fredzqm/CPU/RTL_control_states.xlsx

Sheet: Reg&Op code
OPCODE | 00 | 01 | 10 | 11
00 | add [R] | addi [I] | sto [R] | lui [I]
01 | sub [R] | cmp [R] | cp [R] | cpi [I]
10 | and [R] | xor [R] | push [R] | pop [R]
11 | or [R] | (blank) | jr [R] | jl/jal [J]
REGCODE | 0 | 1 | 10 | 11
0 | t0 | t1 | t2 | t3
1 | t4 | t5 | t6 | t7
10 | s0 | s1 | v0 | v1
11 | s2 | at | ra | dp

Sheet: RTL
 | Calculations | cmp | sto | cp | jr | jl | jal | addi | lui | cpi | push | pop
Cycle 1 | IR = Mem[PC] PC += 1
Cycle 2 | A = R[IR[11:8]] B = R[IR[7:4]] |  |  |  |  | PC += 1 B = Mem[PC] |  | A = R[IR[11:8]] B = R[IR[7:4]] | R[IR[11:8]] = Upper | R[IR[11:8]] = signE | $sp -= 1 | B = Mem[$bp]
LM cycle | A = R[IR[11:8]] B = Mem[B]
Cycle 3 | ALUO= A op B | flag = sign(A - B) | Mem[B] = A | R[IR[11:8]] = B | PC = B | PC = B | PC = B R[IR[11:8]] = PC | ALUO = A + SignE |  |  | Mem[$sp] = A | R[IR[11:8]] = B $sp +=1
Cycle 4 | R[IR[11:8]] = ALUO |  |  |  |  |  |  | R[IR[11:8]] = ALUO

Sheet: Control signals
 | Calculations | cmp | sto | cp | jr | jl | jal | addi | lui | cpi | push | pop
Cycle 1 | IW IorD = 1 PCW
Cycle 2 | LM = 0 |  |  |  |  | PCW LM = 1 IorD = 1 |  | LM = 0 | RW RWSrc = 101 | RW RWSrc = 111 | LM = 0 SPW SPIorD = 0 | LM = 1 IorD = 0 MSrc = 0
LM cycle | LM = 1 IorD = 0 MSrc = 1
Cycle 3 | SrcB = 0 ALUOp = op | SrcB = 0 ALUOp = (A - B) FU = 1 | MW IorD = 0 MSrc = 1 | RW RWSrc = 001 | PCW Jump |  | PCW Jump RW RWSrc = 011 | SrcB = 1 ALUOp = (A + B) |  |  | MW IorD = 0 MSrc = 0 | SPW SPIorD = 1
Cycle 4 | RW RWSrc = xx0 |  |  |  |  |  |  | RW RWSrc = xx0

Sheet: state
 | Calculations | cmp | sto | cp | jr | jl | jal | addi | lui | cpi | push | pop
Cycle 1 | State 1: Read instruction
Cycle 2 | State 2: Decode / load register value / write immediate
LM cycle | State 3: Load memory data
Cycle 3 | State 4: Calculations |  | State 5: memory write | State 6: cp | State 7: jump |  |  | State 4: Calculations |  |  | State 5: memory write | State 8: pop
Cycle 4 | State: 9 Register Write |  |  |  |  |  |  | State: 9 Register Write

Sheet: PCW
PCW = State1 | State2 & op = 1111 | State7
State | op | PCW* | Jump | Explanation
1 | x | 1 | 0 | Increment PC
2 | 1111 | 1 | 0 | skip jump address word
7 | x | 1 | 1 | jump

Sheet: Mem
MW = State5 IW = State1 LM = State2 & op(1) & op(0) | State3 IorD = State1 | State2 & op(2) MSrc = State3 | State5 & ~op(3)
State | op | MW* | IW* | LM | IorD | MSrc | explanation
1 | x | 0 | 1 | x | 1 | x | read instruction
2 | xx0x | 0 | 0 | 0 | x | x
 | 0010 | 0 | 0 | 0 | x | x | sto
 | 0110 | 0 | 0 | 0 | x | x | cp
 | 1010 | 0 | 0 | 0 | x | x | push
 | 1110 | 0 | 0 | 0 | x | x | jr
 | 0011 | 0 | 0 | x | x | x | lui
 | 0111 | 0 | 0 | x | x | x | cpi
 | 1011 | 0 | 0 | 1 | 0 | 0 | read poped data (pop)
 | 1111 | 0 | 0 | 1 | 1 | x | read jump address (jl/jal)
3 | x | 0 | 0 | 1 | 0 | 1 | load memory into B
5 | 0010 | 1 | 0 | x | 0 | 1 | sto
 | 1010 | 1 | 0 | x | 0 | 0 | push

Sheet: RegW
RW = State2 & op(0) & op(1) & ~op(3) | State6 | State7 & op(0) & LMC | State9 RWSrc(0) = ~State9 RWSrc(1) = State2 & op(2) | State7 RWSrc(2) = State2
State | op | LMC | RW* | RWSrc | Explanation
2 | 0011 | x | 1 | 101 | lui
 | 0111 | x | 1 | 111 | cpi
6 | x | x | 1 | 001 | cp
7 | 1111 | 1 | 1 | 011 | jal
9 | x | x | 1 | xx0 | write calculated data

Sheet: ALU
SrcB = State9 & op = 0001 ALUOp = op(3)op(2)op(0)
State | op | SrcB | ALUOp
9 | 0001 | 1 | op(3)op(2)op(0)
 | - | 0
State | op |  | FU
9 | 0101 |  | 1
SPW = State2 & op = 1010 | State*
State | op | SPW* | SPIorD
2 | 1010 | 1 | 0
8 | x | 1 | 1

Sheet: nextState
State | Perform | op |  |  |  | instruct | LM = 0 | LM = 1
 |  | op(1) | op(0) | op(3) | op(2) |  | 0 | 1
State 1: Read instruction | x | x | x | x | x |  | 2 | 2
State 2: Decode / load register value / write immediate | 0 | x | x | x | x |  | 1 | 1
 | 1 | 0 | 0 | x | x |  | 4 | 3
 | 1 | 0 | 1 | 0 | 0 | addi | 4 | 4
 | 1 | 0 | 1 | 0 | 1 | cmp | 4 | 3
 | 1 | 0 | 1 | 1 | 0 | xor | 4 | 3
 | 1 | 1 | 0 | 0 | 0 | sto | 5 | 3
 | 1 | 1 | 0 | 0 | 1 | cp | 6 | 3
 | 1 | 1 | 0 | 1 | 0 | push | 5 | 6
 | 1 | 1 | 0 | 1 | 1 | jr | 7 | 3
 | 1 | 1 | 1 | 0 | 0 | lui | 1 | 1
 | 1 | 1 | 1 | 0 | 1 | cpi | 1 | 1
 | 1 | 1 | 1 | 1 | 0 | pop | 8 | 8
 | 1 | 1 | 1 | 1 | 1 | jl/jal | 7 | 7
State 3: Load memory data | 1 | 0 | x | x | x |  | 4
 | 1 | 1 | 0 | 0 | 0 | sto | 5
 | 1 | 1 | 0 | 0 | 1 | cp | 6
 | 1 | 1 | 0 | 1 | 1 | jr | 7
State 4: Calculations | 1 | 0 | 1 | 0 | 1 | cmp | 1
 | - | - | - | - | - |  | 9
State 5: memory write | 1 | 1 | 0 | 0 | 0 | sto | 1
 | 1 | 1 | 0 | 1 | 0 | push | 1
State 6: cp | 1 | 1 | 0 | 0 | 1 | cp | 1
State 7: jump | 1 | 1 | 0 | 1 | 1 | jr | 1
 | 1 | 1 | 1 | 1 | 1 | jl | 1
 | 1 | 1 | 1 | 1 | 1 | jal | 1
State 8: pop | 1 | 1 | 1 | 1 | 0 | pop | 1
State: 9 Register Write | 1 | 0 | 0 | x | x |  | 1
 | 1 | 0 | 1 | 0 | 0 | addi | 1
 | 1 | 0 | 1 | 1 | 0 | xor | 1

Sheet: nextStateC
State | Perform | op |  |  |  | instruction | LM = 0 | LM = 1
 |  | op(1) | op(0) | op(3) | op(2) |  | 0 | 1
State 1: Read instruction | x | x | x | x | x |  | 2 | 2
State 2: Decode / load register value / write immediate | 0 | x | x | x | x |  | 1 | 1
 | 1 | 0 | 0 | 0 | 0 | add | 4 | 3
 | 1 | 0 | 0 | 0 | 1 | sub | 4 | 3
 | 1 | 0 | 0 | 1 | 0 | and | 4 | 3
 | 1 | 0 | 0 | 1 | 1 | or | 4 | 3
 | 1 | 0 | 1 | 0 | 0 | addi | 4 | 4 | OPCODE | 00 | 01 | 10 | 11
 | 1 | 0 | 1 | 0 | 1 | cmp | 4 | 3 | 00 | add [R] | addi [I] | sto [R] | lui [I]
 | 1 | 0 | 1 | 1 | 0 | xor | 4 | 3 | 01 | sub [R] | cmp [R] | cp [R] | cpi [I]
 | 1 | 0 | 1 | 1 | 1 | ??? | x | x | 10 | and [R] | xor [R] | push [R] | pop [R]
 | 1 | 1 | 0 | 0 | 0 | sto | 5 | 3 | 11 | or [R] | (blank) | jr [R] | jl/jal [J]
 | 1 | 1 | 0 | 0 | 1 | cp | 6 | 3
 | 1 | 1 | 0 | 1 | 0 | push | 5 | 6
 | 1 | 1 | 0 | 1 | 1 | jr | 7 | 3
 | 1 | 1 | 1 | 0 | 0 | lui | 1 | 1
 | 1 | 1 | 1 | 0 | 1 | cpi | 1 | 1
 | 1 | 1 | 1 | 1 | 0 | pop | 8 | 8
 | 1 | 1 | 1 | 1 | 1 | jl | 7 | 7
 | 1 | 1 | 1 | 1 | 1 | jal | 7 | 7
State 3: Load memory data | 0 | x | x | x | x |  | x | x
 | 1 | 0 | 0 | 0 | 0 | add | x | 4
 | 1 | 0 | 0 | 0 | 1 | sub | x | 4
 | 1 | 0 | 0 | 1 | 0 | and | x | 4
 | 1 | 0 | 0 | 1 | 1 | or | x | 4
 | 1 | 0 | 1 | 0 | 0 | addi | x | x
 | 1 | 0 | 1 | 0 | 1 | cmp | x | 4
 | 1 | 0 | 1 | 1 | 0 | xor | x | 4
 | 1 | 0 | 1 | 1 | 1 | ??? | x | x
 | 1 | 1 | 0 | 0 | 0 | sto | x | 5
 | 1 | 1 | 0 | 0 | 1 | cp | x | 6
 | 1 | 1 | 0 | 1 | 0 | push | x | x
 | 1 | 1 | 0 | 1 | 1 | jr | x | 7
 | 1 | 1 | 1 | 0 | 0 | lui | x | x
 | 1 | 1 | 1 | 0 | 1 | cpi | x | x
 | 1 | 1 | 1 | 1 | 0 | pop | x | x
 | 1 | 1 | 1 | 1 | 1 | jl | x | x
 | 1 | 1 | 1 | 1 | 1 | jal | x | x
State 4: Calculations | 0 | x | x | x | x |  | x | x
 | 1 | 0 | 0 | 0 | 0 | add | 9 | 9
 | 1 | 0 | 0 | 0 | 1 | sub | 9 | 9
 | 1 | 0 | 0 | 1 | 0 | and | 9 | 9
 | 1 | 0 | 0 | 1 | 1 | or | 9 | 9
 | 1 | 0 | 1 | 0 | 0 | addi | 9 | 9
 | 1 | 0 | 1 | 0 | 1 | cmp | 1 | 1
 | 1 | 0 | 1 | 1 | 0 | xor | 9 | 9
 | 1 | 0 | 1 | 1 | 1 | ??? | x | x
 | 1 | 1 | 0 | 0 | 0 | sto | x | x
 | 1 | 1 | 0 | 0 | 1 | cp | x | x
 | 1 | 1 | 0 | 1 | 0 | push | x | x
 | 1 | 1 | 0 | 1 | 1 | jr | x | x
 | 1 | 1 | 1 | 0 | 0 | lui | x | x
 | 1 | 1 | 1 | 0 | 1 | cpi | x | x
 | 1 | 1 | 1 | 1 | 0 | pop | x | x
 | 1 | 1 | 1 | 1 | 1 | jl | x | x
 | 1 | 1 | 1 | 1 | 1 | jal | x | x
State 5: memory write | 0 | x | x | x | x |  | x | x
 | 1 | 0 | 0 | 0 | 0 | add | x | x
 | 1 | 0 | 0 | 0 | 1 | sub | x | x
 | 1 | 0 | 0 | 1 | 0 | and | x | x
 | 1 | 0 | 0 | 1 | 1 | or | x | x
 | 1 | 0 | 1 | 0 | 0 | addi | x | x
 | 1 | 0 | 1 | 0 | 1 | cmp | x | x
 | 1 | 0 | 1 | 1 | 0 | xor | x | x
 | 1 | 0 | 1 | 1 | 1 | ??? | x | x
 | 1 | 1 | 0 | 0 | 0 | sto | 1 | 1
 | 1 | 1 | 0 | 0 | 1 | cp | x | x
 | 1 | 1 | 0 | 1 | 0 | push | 1 | 1
 | 1 | 1 | 0 | 1 | 1 | jr | x | x
 | 1 | 1 | 1 | 0 | 0 | lui | x | x
 | 1 | 1 | 1 | 0 | 1 | cpi | x | x
 | 1 | 1 | 1 | 1 | 0 | pop | x | x
 | 1 | 1 | 1 | 1 | 1 | jl | x | x
 | 1 | 1 | 1 | 1 | 1 | jal | x | x
State 6: cp | 0 | x | x | x | x |  | x | x
 | 1 | 0 | 0 | 0 | 0 | add | x | x
 | 1 | 0 | 0 | 0 | 1 | sub | x | x
 | 1 | 0 | 0 | 1 | 0 | and | x | x
 | 1 | 0 | 0 | 1 | 1 | or | x | x
 | 1 | 0 | 1 | 0 | 0 | addi | x | x
 | 1 | 0 | 1 | 0 | 1 | cmp | x | x
 | 1 | 0 | 1 | 1 | 0 | xor | x | x
 | 1 | 0 | 1 | 1 | 1 | ??? | x | x
 | 1 | 1 | 0 | 0 | 0 | sto | x | x
 | 1 | 1 | 0 | 0 | 1 | cp | 1 | 1
 | 1 | 1 | 0 | 1 | 0 | push | x | x
 | 1 | 1 | 0 | 1 | 1 | jr | x | x
 | 1 | 1 | 1 | 0 | 0 | lui | x | x
 | 1 | 1 | 1 | 0 | 1 | cpi | x | x
 | 1 | 1 | 1 | 1 | 0 | pop | x | x
 | 1 | 1 | 1 | 1 | 1 | jl | x | x
 | 1 | 1 | 1 | 1 | 1 | jal | x | x
State 7: jump | 0 | x | x | x | x |  | x | x
 | 1 | 0 | 0 | 0 | 0 | add | x | x
 | 1 | 0 | 0 | 0 | 1 | sub | x | x
 | 1 | 0 | 0 | 1 | 0 | and | x | x
 | 1 | 0 | 0 | 1 | 1 | or | x | x
 | 1 | 0 | 1 | 0 | 0 | addi | x | x
 | 1 | 0 | 1 | 0 | 1 | cmp | x | x
 | 1 | 0 | 1 | 1 | 0 | xor | x | x
 | 1 | 0 | 1 | 1 | 1 | ??? | x | x
 | 1 | 1 | 0 | 0 | 0 | sto | x | x
 | 1 | 1 | 0 | 0 | 1 | cp | x | x
 | 1 | 1 | 0 | 1 | 0 | push | x | x
 | 1 | 1 | 0 | 1 | 1 | jr | 1 | x
 | 1 | 1 | 1 | 0 | 0 | lui | x | x
 | 1 | 1 | 1 | 0 | 1 | cpi | x | x
 | 1 | 1 | 1 | 1 | 0 | pop | x | x
 | 1 | 1 | 1 | 1 | 1 | jl | 1 | x
 | 1 | 1 | 1 | 1 | 1 | jal | 1 | x
State 8: pop | 0 | x | x | x | x |  | x | x
 | 1 | 0 | 0 | 0 | 0 | add | x | x
 | 1 | 0 | 0 | 0 | 1 | sub | x | x
 | 1 | 0 | 0 | 1 | 0 | and | x | x
 | 1 | 0 | 0 | 1 | 1 | or | x | x
 | 1 | 0 | 1 | 0 | 0 | addi | x | x
 | 1 | 0 | 1 | 0 | 1 | cmp | x | x
 | 1 | 0 | 1 | 1 | 0 | xor | x | x
 | 1 | 0 | 1 | 1 | 1 | ??? | x | x
 | 1 | 1 | 0 | 0 | 0 | sto | x | x
 | 1 | 1 | 0 | 0 | 1 | cp | x | x
 | 1 | 1 | 0 | 1 | 0 | push | x | x
 | 1 | 1 | 0 | 1 | 1 | jr | x | x
 | 1 | 1 | 1 | 0 | 0 | lui | x | x
 | 1 | 1 | 1 | 0 | 1 | cpi | x | x
 | 1 | 1 | 1 | 1 | 0 | pop | 1 | 1
 | 1 | 1 | 1 | 1 | 1 | jl | x | x
 | 1 | 1 | 1 | 1 | 1 | jal | x | x
State: 9 Register Write | 0 | x | x | x | x |  | x | x
 | 1 | 0 | 0 | 0 | 0 | add | 1 | 1
 | 1 | 0 | 0 | 0 | 1 | sub | 1 | 1
 | 1 | 0 | 0 | 1 | 0 | and | 1 | 1
 | 1 | 0 | 0 | 1 | 1 | or | 1 | 1
 | 1 | 0 | 1 | 0 | 0 | addi | 1 | 1
 | 1 | 0 | 1 | 0 | 1 | cmp | x | x
 | 1 | 0 | 1 | 1 | 0 | xor | 1 | 1
 | 1 | 0 | 1 | 1 | 1 | ??? | x | x
 | 1 | 1 | 0 | 0 | 0 | sto | x | x
 | 1 | 1 | 0 | 0 | 1 | cp | x | x
 | 1 | 1 | 0 | 1 | 0 | push | x | x
 | 1 | 1 | 0 | 1 | 1 | jr | x | x
 | 1 | 1 | 1 | 0 | 0 | lui | x | x
 | 1 | 1 | 1 | 0 | 1 | cpi | x | x
 | 1 | 1 | 1 | 1 | 0 | pop | x | x
 | 1 | 1 | 1 | 1 | 1 | jl | x | x
 | 1 | 1 | 1 | 1 | 1 | jal | x | x
