fredzqm/CPU/Xilinx_implementation/SystemTest/calc instructions.docx

writeMem(10, 16'b0110000100101111);

writeReg( 2, 16'h0112);

writeMem(16'h0112, 12);

run(10,1);

readReg(1, out);

if(out == 12)

$display("----------------good cp1" );

else

$display("-----------------bad cp1" );

writeMem(11, 16'b0110000100100111);

writeReg( 2, 16'h0033);

run(11,1);

readReg(1, out);

if(out == 16'h0033)

$display("----------------good cp2" );

else

$display("-----------------bad cp2" );

writeMem(12, 16'b0110000100100100);

writeReg( 2, 16'h0022);

run(12,1);

readReg(1, out);

if(out == 16'h0033)

$display("----------------good cp3" );

else

$display("-----------------bad cp3" );

writeMem(13, 16'b0000000100100111);

writeReg( 1, 16'h0002);

writeReg( 2, 16'h0003);

run(13,1);

readReg(1, out);

if(out == 16'h0005)

$display("----------------good add1" );

else

$display("-----------------bad add1" );

writeMem(14, 16'b0000000100101111);

writeReg( 1, 16'h0003);

writeReg( 2, 16'h0002);

writeMem( 2, 4);

run(14,1);

readReg(1, out);

if(out == 16'h0007)

$display("----------------good add2" );

else

$display("-----------------bad add2" );

writeMem(15, 16'b0000000100100110);

writeReg( 1, 16'h0002);

writeReg( 2, 16'h0003);

run(15,1);

readReg(1, out);

if(out == 16'h0002)

$display("----------------good add3" );

else

$display("-----------------bad add3" );

writeMem(16, 16'b0000000100100111);

writeReg( 1, 16'h7fff);

writeReg( 2, 16'h0001);

run(16,1);

readReg(1, out);

if(out == 16'h8000)

$display("----------------good add4" );

else

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

else

$display("-----------------bad or2" );

writeMem(32, 16'b1100000100100100);

writeReg( 1, 16'h0002);

writeReg( 2, 16'h0003);

run(32,1);

readReg(1, out);

if(out == 16'h0002)

$display("----------------good or3" );

else

$display("-----------------bad or3" );
