fredzqm/CPU/StateDiagram.pdf

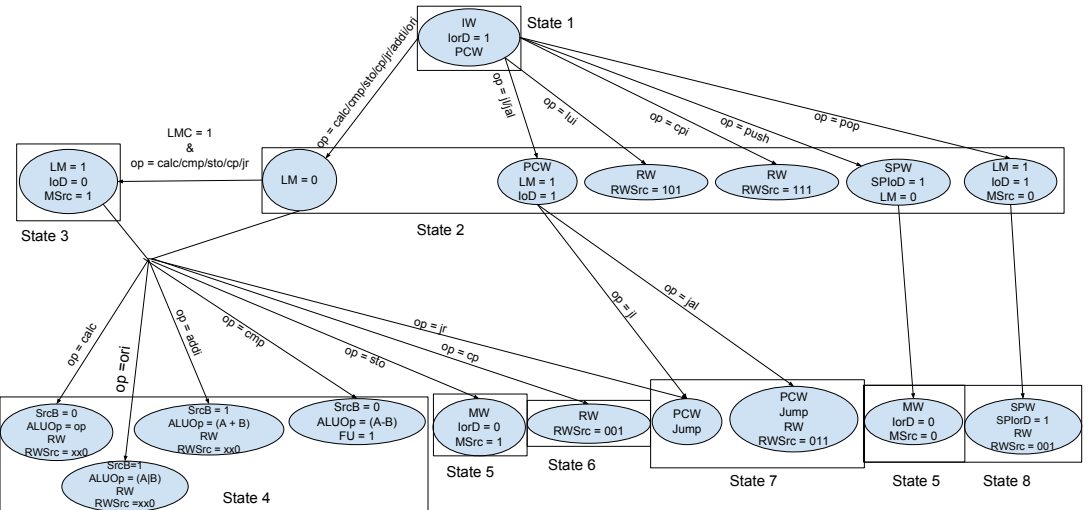
[picture p8: page 1]
IW IorD = 1 PCW; PCW LM = 1 IoD = 1; RW RWSrc = 101; RW RWSrc = 111; SPW SPIoD = 1 LM = 0; LM = 1 IoD = 1 MSrc = 0; LM = 1 IoD = 0 MSrc = 1; SrcB = 0 ALUOp = op RW RWSrc = xx0; SrcB = 0 ALUOp = (A-B) FU = 1; MW IorD = 0 MSrc = 1; RW RWSrc = 001; PCW Jump; SrcB = 1 ALUOp = (A + B) RW RWSrc = xx0; PCW Jump RW RWSrc = 011; MW IorD = 0 MSrc = 0; SPW SPIorD = 1 RW RWSrc = 001; LMC = 1 &; op = cpi; op = push; op = pop; op = lui; op = jal; op = sto; op = addi; op = calc; op = cmp; State 1; State 7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

op = calc/cmp/sto/cp/jr/addi/ori

op = jl/jal

op = calc/cmp/sto/cp/jr
