fredzqm/CPU/Xilinx_implementation/IO/debounce/ipcore_dir/debounce_counter.v

////////////////////////////////////////////////////////////////////////////////
// Copyright (c) 1995-2013 Xilinx, Inc.  All rights reserved.
////////////////////////////////////////////////////////////////////////////////
//   ____  ____
//  /   /\/   /
// /___/  \  /    Vendor: Xilinx
// \   \   \/     Version: P.20131013
//  \   \         Application: netgen
//  /   /         Filename: debounce_counter.v
// /___/   /\     Timestamp: Mon Nov  9 21:00:09 2015
// \   \  /  \ 
//  \___\/\___\
//             
// Command	: -w -sim -ofmt verilog /home/fredzqm/cpu-csse232/1516a-csse232-fineral-kerrickm-yangr-zhangq2/Xilinx/IO/debounce/ipcore_dir/tmp/_cg/debounce_counter.ngc /home/fredzqm/cpu-csse232/1516a-csse232-fineral-kerrickm-yangr-zhangq2/Xilinx/IO/debounce/ipcore_dir/tmp/_cg/debounce_counter.v 
// Device	: 3s500efg320-4
// Input file	: /home/fredzqm/cpu-csse232/1516a-csse232-fineral-kerrickm-yangr-zhangq2/Xilinx/IO/debounce/ipcore_dir/tmp/_cg/debounce_counter.ngc
// Output file	: /home/fredzqm/cpu-csse232/1516a-csse232-fineral-kerrickm-yangr-zhangq2/Xilinx/IO/debounce/ipcore_dir/tmp/_cg/debounce_counter.v
// # of Modules	: 1
// Design Name	: debounce_counter
// Xilinx        : /opt/Xilinx/14.7/ISE_DS/ISE/
//             
// Purpose:    
//     This verilog netlist is a verification model and uses simulation 
//     primitives which may not represent the true implementation of the 
//     device, however the netlist is functionally correct and should not 
//     be modified. This file cannot be synthesized and should only be used 
//     with supported simulation tools.
//             
// Reference:  
//     Command Line Tools User Guide, Chapter 23 and Synthesis and Simulation Design Guide, Chapter 6
//             
////////////////////////////////////////////////////////////////////////////////

`timescale 1 ns/1 ps

module debounce_counter (
  clk, ce, thresh0, sclr, q
)/* synthesis syn_black_box syn_noprune=1 */;
  input clk;
  input ce;
  output thresh0;
  input sclr;
  output [15 : 0] q;
  
  // synthesis translate_off
  
  wire \blk00000001/sig0000004b ;
  wire \blk00000001/sig0000004a ;
  wire \blk00000001/sig00000049 ;
  wire \blk00000001/sig00000048 ;
  wire \blk00000001/sig00000047 ;
  wire \blk00000001/sig00000046 ;
  wire \blk00000001/sig00000045 ;
  wire \blk00000001/sig00000044 ;
  wire \blk00000001/sig00000043 ;
  wire \blk00000001/sig00000042 ;
  wire \blk00000001/sig00000041 ;
  wire \blk00000001/sig00000040 ;
  wire \blk00000001/sig0000003f ;
  wire \blk00000001/sig0000003e ;
  wire \blk00000001/sig0000003d ;
  wire \blk00000001/sig0000003c ;
  wire \blk00000001/sig0000003b ;
  wire \blk00000001/sig0000003a ;
  wire \blk00000001/sig00000039 ;
  wire \blk00000001/sig00000038 ;
  wire \blk00000001/sig00000027 ;
  wire \blk00000001/sig00000026 ;
  wire \blk00000001/sig00000025 ;
  wire \blk00000001/sig00000024 ;
  wire \blk00000001/sig00000023 ;
  wire \blk00000001/sig00000022 ;
  wire \blk00000001/sig00000021 ;
  wire \blk00000001/sig00000020 ;
  wire \blk00000001/sig0000001f ;
  wire \blk00000001/sig0000001e ;
  wire \blk00000001/sig0000001d ;
  wire \blk00000001/sig0000001c ;
  wire \blk00000001/sig0000001b ;
  wire \blk00000001/sig0000001a ;
  wire \blk00000001/sig00000019 ;
  wire \blk00000001/sig00000018 ;
  wire \blk00000001/sig00000016 ;
  wire \blk00000001/sig00000015 ;
  wire \blk00000001/sig00000014 ;
  wire \blk00000001/sig00000013 ;
  wire \blk00000001/sig00000012 ;
  wire \blk00000001/sig00000011 ;
  wire \blk00000001/sig00000010 ;
  wire \blk00000001/sig0000000f ;
  wire \blk00000001/sig0000000e ;
  wire \blk00000001/sig0000000d ;
  wire \blk00000001/sig0000000c ;
  wire \blk00000001/sig0000000b ;
  wire \blk00000001/sig0000000a ;
  wire \blk00000001/sig00000009 ;
  wire \blk00000001/sig00000008 ;
  wire \blk00000001/sig00000007 ;
  wire \blk00000001/sig00000005 ;
  wire \blk00000001/sig00000004 ;
  wire \blk00000001/sig00000003 ;
  wire [15 : 0] NlwRenamedSig_OI_q;
  assign
    q[15] = NlwRenamedSig_OI_q[15],
    q[14] = NlwRenamedSig_OI_q[14],
    q[13] = NlwRenamedSig_OI_q[13],
    q[12] = NlwRenamedSig_OI_q[12],
    q[11] = NlwRenamedSig_OI_q[11],
    q[10] = NlwRenamedSig_OI_q[10],
    q[9] = NlwRenamedSig_OI_q[9],
    q[8] = NlwRenamedSig_OI_q[8],
    q[7] = NlwRenamedSig_OI_q[7],
    q[6] = NlwRenamedSig_OI_q[6],
    q[5] = NlwRenamedSig_OI_q[5],
    q[4] = NlwRenamedSig_OI_q[4],
    q[3] = NlwRenamedSig_OI_q[3],
    q[2] = NlwRenamedSig_OI_q[2],
    q[1] = NlwRenamedSig_OI_q[1],
    q[0] = NlwRenamedSig_OI_q[0];
  LUT4_L #(
    .INIT ( 16'h8000 ))
  \blk00000001/blk00000049  (
    .I0(\blk00000001/sig0000000a ),
    .I1(\blk00000001/sig00000009 ),
    .I2(\blk00000001/sig00000012 ),
    .I3(\blk00000001/sig00000004 ),
    .LO(\blk00000001/sig00000049 )
  );
  LUT2_L #(
    .INIT ( 4'h8 ))
  \blk00000001/blk00000048  (
    .I0(\blk00000001/sig00000007 ),
    .I1(\blk00000001/sig0000000e ),
    .LO(\blk00000001/sig0000004b )
  );
  INV   \blk00000001/blk00000047  (
    .I(NlwRenamedSig_OI_q[0]),
    .O(\blk00000001/sig00000027 )
  );
  LUT3 #(
    .INIT ( 8'h80 ))
  \blk00000001/blk00000046  (
    .I0(\blk00000001/sig0000000f ),
    .I1(\blk00000001/sig00000010 ),
    .I2(\blk00000001/sig00000011 ),
    .O(\blk00000001/sig00000004 )
  );
  LUT1 #(
    .INIT ( 2'h2 ))
  \blk00000001/blk00000045  (
    .I0(NlwRenamedSig_OI_q[14]),
    .O(\blk00000001/sig0000003c )
  );
  LUT1 #(
    .INIT ( 2'h2 ))
  \blk00000001/blk00000044  (
    .I0(NlwRenamedSig_OI_q[13]),
    .O(\blk00000001/sig0000003b )
  );
  LUT1 #(
    .INIT ( 2'h2 ))
  \blk00000001/blk00000043  (
    .I0(NlwRenamedSig_OI_q[12]),
    .O(\blk00000001/sig0000003a )
  );
  LUT1 #(
    .INIT ( 2'h2 ))
  \blk00000001/blk00000042  (
    .I0(NlwRenamedSig_OI_q[11]),
    .O(\blk00000001/sig00000039 )
  );
  LUT1 #(
    .INIT ( 2'h2 ))
  \blk00000001/blk00000041  (
    .I0(NlwRenamedSig_OI_q[10]),
    .O(\blk00000001/sig00000038 )
  );
  LUT1 #(
    .INIT ( 2'h2 ))
  \blk00000001/blk00000040  (
    .I0(NlwRenamedSig_OI_q[9]),
    .O(\blk00000001/sig00000045 )
  );
  LUT1 #(
    .INIT ( 2'h2 ))
  \blk00000001/blk0000003f  (
    .I0(NlwRenamedSig_OI_q[8]),
    .O(\blk00000001/sig00000044 )
  );
  LUT1 #(
    .INIT ( 2'h2 ))
  \blk00000001/blk0000003e  (
    .I0(NlwRenamedSig_OI_q[7]),
    .O(\blk00000001/sig00000043 )
  );
  LUT1 #(
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
  );
  XORCY   \blk00000001/blk00000012  (
    .CI(\blk00000001/sig00000022 ),
    .LI(\blk00000001/sig00000042 ),
    .O(\blk00000001/sig00000013 )
  );
  MUXCY   \blk00000001/blk00000011  (
    .CI(\blk00000001/sig00000022 ),
    .DI(\blk00000001/sig00000003 ),
    .S(\blk00000001/sig00000042 ),
    .O(\blk00000001/sig00000023 )
  );
  XORCY   \blk00000001/blk00000010  (
    .CI(\blk00000001/sig00000021 ),
    .LI(\blk00000001/sig00000041 ),
    .O(\blk00000001/sig00000012 )
  );
  MUXCY   \blk00000001/blk0000000f  (
    .CI(\blk00000001/sig00000021 ),
    .DI(\blk00000001/sig00000003 ),
    .S(\blk00000001/sig00000041 ),
    .O(\blk00000001/sig00000022 )
  );
  XORCY   \blk00000001/blk0000000e  (
    .CI(\blk00000001/sig00000020 ),
    .LI(\blk00000001/sig00000040 ),
    .O(\blk00000001/sig00000011 )
  );
  MUXCY   \blk00000001/blk0000000d  (
    .CI(\blk00000001/sig00000020 ),
    .DI(\blk00000001/sig00000003 ),
    .S(\blk00000001/sig00000040 ),
    .O(\blk00000001/sig00000021 )
  );
  XORCY   \blk00000001/blk0000000c  (
    .CI(\blk00000001/sig0000001f ),
    .LI(\blk00000001/sig0000003f ),
    .O(\blk00000001/sig00000010 )
  );
  MUXCY   \blk00000001/blk0000000b  (
    .CI(\blk00000001/sig0000001f ),
    .DI(\blk00000001/sig00000003 ),
    .S(\blk00000001/sig0000003f ),
    .O(\blk00000001/sig00000020 )
  );
  XORCY   \blk00000001/blk0000000a  (
    .CI(\blk00000001/sig0000001e ),
    .LI(\blk00000001/sig0000003e ),
    .O(\blk00000001/sig0000000f )
  );
  MUXCY   \blk00000001/blk00000009  (
    .CI(\blk00000001/sig0000001e ),
    .DI(\blk00000001/sig00000003 ),
    .S(\blk00000001/sig0000003e ),
    .O(\blk00000001/sig0000001f )
  );
  XORCY   \blk00000001/blk00000008  (
    .CI(\blk00000001/sig00000018 ),
    .LI(\blk00000001/sig0000003d ),
    .O(\blk00000001/sig0000000e )
  );
  MUXCY   \blk00000001/blk00000007  (
    .CI(\blk00000001/sig00000018 ),
    .DI(\blk00000001/sig00000003 ),
    .S(\blk00000001/sig0000003d ),
    .O(\blk00000001/sig0000001e )
  );
  XORCY   \blk00000001/blk00000006  (
    .CI(\blk00000001/sig0000001d ),
    .LI(NlwRenamedSig_OI_q[15]),
    .O(\blk00000001/sig0000000d )
  );
  XORCY   \blk00000001/blk00000005  (
    .CI(\blk00000001/sig00000003 ),
    .LI(\blk00000001/sig00000027 ),
    .O(\blk00000001/sig00000007 )
  );
  MUXCY   \blk00000001/blk00000004  (
    .CI(\blk00000001/sig00000003 ),
    .DI(\blk00000001/sig00000005 ),
    .S(\blk00000001/sig00000027 ),
    .O(\blk00000001/sig00000018 )
  );
  VCC   \blk00000001/blk00000003  (
    .P(\blk00000001/sig00000005 )
  );
  GND   \blk00000001/blk00000002  (
    .G(\blk00000001/sig00000003 )
  );

// synthesis translate_on

endmodule

// synthesis translate_off

`ifndef GLBL
`define GLBL

`timescale  1 ps / 1 ps

module glbl ();

    parameter ROC_WIDTH = 100000;
    parameter TOC_WIDTH = 0;

//--------   STARTUP Globals --------------
    wire GSR;
    wire GTS;
    wire GWE;
    wire PRLD;
    tri1 p_up_tmp;
    tri (weak1, strong0) PLL_LOCKG = p_up_tmp;

    wire PROGB_GLBL;
    wire CCLKO_GLBL;

    reg GSR_int;
    reg GTS_int;
    reg PRLD_int;

//--------   JTAG Globals --------------
    wire JTAG_TDO_GLBL;
    wire JTAG_TCK_GLBL;
    wire JTAG_TDI_GLBL;
    wire JTAG_TMS_GLBL;
    wire JTAG_TRST_GLBL;

    reg JTAG_CAPTURE_GLBL;
    reg JTAG_RESET_GLBL;
    reg JTAG_SHIFT_GLBL;
    reg JTAG_UPDATE_GLBL;
    reg JTAG_RUNTEST_GLBL;

    reg JTAG_SEL1_GLBL = 0;
    reg JTAG_SEL2_GLBL = 0 ;
    reg JTAG_SEL3_GLBL = 0;
    reg JTAG_SEL4_GLBL = 0;

    reg JTAG_USER_TDO1_GLBL = 1'bz;
    reg JTAG_USER_TDO2_GLBL = 1'bz;
    reg JTAG_USER_TDO3_GLBL = 1'bz;
    reg JTAG_USER_TDO4_GLBL = 1'bz;

    assign (weak1, weak0) GSR = GSR_int;
    assign (weak1, weak0) GTS = GTS_int;
    assign (weak1, weak0) PRLD = PRLD_int;

    initial begin
	GSR_int = 1'b1;
	PRLD_int = 1'b1;
	#(ROC_WIDTH)
	GSR_int = 1'b0;
	PRLD_int = 1'b0;
    end

    initial begin
	GTS_int = 1'b1;
	#(TOC_WIDTH)
	GTS_int = 1'b0;
    end

endmodule

`endif

// synthesis translate_on
