fredzqm/CPU/Xilinx_implementation/Buff16.v

`timescale 1ns / 1ps
//////////////////////////////////////////////////////////////////////////////////
// Company: 
// Engineer: 
// 
// Create Date:    21:23:36 11/08/2015 
// Design Name: 
// Module Name:    Buff16 
// Project Name: 
// Target Devices: 
// Tool versions: 
// Description: 
//
// Dependencies: 
//
// Revision: 
// Revision 0.01 - File Created
// Additional Comments: 
//
//////////////////////////////////////////////////////////////////////////////////
module Buff16(
    input [15:0] a,
    output [15:0] b
    );
	assign b = a;

endmodule
