fredzqm/CPU/Xilinx_implementation/Register.v

`timescale 1ns / 1ps
//////////////////////////////////////////////////////////////////////////////////
// Company: 
// Engineer: 
// 
// Create Date:    02:14:56 11/03/2015 
// Design Name: 
// Module Name:    Register 
// Project Name: 
// Target Devices: 
// Tool versions: 
// Description: 
//
// Dependencies: 
//
// Revision: 
// Revision 0.01 - File Created
// Additional Comments: 
//
//////////////////////////////////////////////////////////////////////////////////
module Register(
    input [15:0] D,
    input EN,
    output reg[15:0] Q,
	 input CLK
    );
	
	always @(posedge CLK)
		if (EN == 1)
			Q <= D;

endmodule
