fredzqm/CPU/Xilinx_implementation/netgen/synthesis/DatapathTest_synthesis.v

////////////////////////////////////////////////////////////////////////////////
// Copyright (c) 1995-2013 Xilinx, Inc.  All rights reserved.
////////////////////////////////////////////////////////////////////////////////
//   ____  ____
//  /   /\/   /
// /___/  \  /    Vendor: Xilinx
// \   \   \/     Version: P.20131013
//  \   \         Application: netgen
//  /   /         Filename: DatapathTest_synthesis.v
// /___/   /\     Timestamp: Sat Oct 31 23:05:54 2015
// \   \  /  \ 
//  \___\/\___\
//             
// Command	: -intstyle ise -insert_glbl true -w -dir netgen/synthesis -ofmt verilog -sim DatapathTest.ngc DatapathTest_synthesis.v 
// Device	: xc3s500e-4-fg320
// Input file	: DatapathTest.ngc
// Output file	: /home/fredzqm/cpu-csse232/1516a-csse232-fineral-kerrickm-yangr-zhangq2/Xilinx/netgen/synthesis/DatapathTest_synthesis.v
// # of Modules	: 1
// Design Name	: DatapathTest
// Xilinx        : /opt/Xilinx/14.7/ISE_DS/ISE/
//             
// Purpose:    
//     This verilog netlist is a verification model and uses simulation 
//     primitives which may not represent the true implementation of the 
//     device, however the netlist is functionally correct and should not 
//     be modified. This file cannot be synthesized and should only be used 
//     with supported simulation tools.
//             
// Reference:  
//     Command Line Tools User Guide, Chapter 23 and Synthesis and Simulation Design Guide, Chapter 6
//             
////////////////////////////////////////////////////////////////////////////////

`timescale 1 ns/1 ps

module DatapathTest (
  CLK, MSrc, LMC, RESET, FU, SPW, IW, Jump, LM, M, R, MW, SrcB, PCW, Perform, RW, SPIorD, IorD, MD, Op, RD, SP, RWSrc, MemA, ALUOp, RA, RESETPC
)/* synthesis syn_black_box syn_noprune=1 */;
  input CLK;
  input MSrc;
  output LMC;
  input RESET;
  input FU;
  input SPW;
  input IW;
  input Jump;
  input LM;
  input M;
  input R;
  input MW;
  input SrcB;
  input PCW;
  output Perform;
  input RW;
  input SPIorD;
  input IorD;
  output [15 : 0] MD;
  output [3 : 0] Op;
  output [15 : 0] RD;
  output [15 : 0] SP;
  input [2 : 0] RWSrc;
  input [15 : 0] MemA;
  input [2 : 0] ALUOp;
  input [3 : 0] RA;
  input [15 : 0] RESETPC;
  
  // synthesis translate_off
  
  wire ALUOp_0_IBUF_175;
  wire ALUOp_1_IBUF_176;
  wire ALUOp_2_IBUF_177;
  wire CLK_BUFGP_195;
  wire FU_BUFGP_197;
  wire IW_IBUF_199;
  wire IorD_IBUF_201;
  wire Jump_IBUF_203;
  wire LM_IBUF_206;
  wire MD_0_OBUF_224;
  wire MD_10_OBUF_225;
  wire MD_11_OBUF_226;
  wire MD_12_OBUF_227;
  wire MD_13_OBUF_228;
  wire MD_14_OBUF_229;
  wire MD_15_OBUF_230;
  wire MD_1_OBUF_231;
  wire MD_2_OBUF_232;
  wire MD_3_OBUF_233;
  wire MD_4_OBUF_234;
  wire MD_5_OBUF_235;
  wire MD_6_OBUF_236;
  wire MD_7_OBUF_237;
  wire MD_8_OBUF_238;
  wire MD_9_OBUF_239;
  wire MSrc_IBUF_241;
  wire MW_IBUF_243;
  wire M_IBUF_244;
  wire MemA_0_IBUF_259;
  wire MemA_10_IBUF_260;
  wire MemA_11_IBUF_261;
  wire MemA_14_IBUF_262;
  wire MemA_15_IBUF_263;
  wire MemA_1_IBUF_264;
  wire MemA_2_IBUF_265;
  wire MemA_3_IBUF_266;
  wire MemA_4_IBUF_267;
  wire MemA_5_IBUF_268;
  wire MemA_6_IBUF_269;
  wire MemA_7_IBUF_270;
  wire MemA_8_IBUF_271;
  wire MemA_9_IBUF_272;
  wire N48;
  wire N68;
  wire \PC[0] ;
  wire \PC[10] ;
  wire \PC[11] ;
  wire \PC[14] ;
  wire \PC[15] ;
  wire \PC[1] ;
  wire \PC[2] ;
  wire \PC[3] ;
  wire \PC[4] ;
  wire \PC[5] ;
  wire \PC[6] ;
  wire \PC[7] ;
  wire \PC[8] ;
  wire \PC[9] ;
  wire PCW_IBUF_294;
  wire Perform_OBUF_296;
  wire RA_0_IBUF_302;
  wire RA_1_IBUF_303;
  wire RA_2_IBUF_304;
  wire RA_3_IBUF_305;
  wire RD_0_OBUF_322;
  wire RD_10_OBUF_323;
  wire RD_11_OBUF_324;
  wire RD_12_OBUF_325;
  wire RD_13_OBUF_326;
  wire RD_14_OBUF_327;
  wire RD_15_OBUF_328;
  wire RD_1_OBUF_329;
  wire RD_2_OBUF_330;
  wire RD_3_OBUF_331;
  wire RD_4_OBUF_332;
  wire RD_5_OBUF_333;
  wire RD_6_OBUF_334;
  wire RD_7_OBUF_335;
  wire RD_8_OBUF_336;
  wire RD_9_OBUF_337;
  wire RESETPC_0_IBUF_355;
  wire RESETPC_10_IBUF_356;
  wire RESETPC_11_IBUF_357;
  wire RESETPC_12_IBUF_358;
  wire RESETPC_13_IBUF_359;
  wire RESETPC_14_IBUF_360;
  wire RESETPC_15_IBUF_361;
  wire RESETPC_1_IBUF_362;
  wire RESETPC_2_IBUF_363;
  wire RESETPC_3_IBUF_364;
  wire RESETPC_4_IBUF_365;
  wire RESETPC_5_IBUF_366;
  wire RESETPC_6_IBUF_367;
  wire RESETPC_7_IBUF_368;
  wire RESETPC_8_IBUF_369;
  wire RESETPC_9_IBUF_370;
  wire RESET_IBUF_371;
  wire RWSrc_0_IBUF_376;
  wire RWSrc_1_IBUF_377;
  wire RWSrc_2_IBUF_378;
  wire RW_IBUF_379;
  wire R_IBUF_380;
  wire SPIorD_IBUF_398;
  wire SPW_IBUF_400;
  wire SrcB_IBUF_402;
  wire \XLXI_157/o<0>12_403 ;
  wire \XLXI_157/o<0>19_404 ;
  wire \XLXI_167/ALUOp<2>101 ;
  wire \XLXI_167/ALUOp<2>11 ;
  wire \XLXI_167/ALUOp<2>121 ;
  wire \XLXI_167/ALUOp<2>131 ;
  wire \XLXI_167/ALUOp<2>141 ;
  wire \XLXI_167/ALUOp<2>151 ;
  wire \XLXI_167/ALUOp<2>21 ;
  wire \XLXI_167/ALUOp<2>3 ;
  wire \XLXI_167/ALUOp<2>31 ;
  wire \XLXI_167/ALUOp<2>81 ;
  wire \XLXI_167/ALUOp<2>_6_f510 ;
  wire \XLXI_167/ALUOp<2>_6_f53 ;
  wire \XLXI_167/ALUOp<2>_6_f54 ;
  wire \XLXI_167/ALUOp<2>_6_f55 ;
  wire \XLXI_167/ALUOp<2>_6_f56 ;
  wire \XLXI_167/ALUOp<2>_6_f58 ;
  wire \XLXI_167/ALUOut_mux0000 ;
  wire \XLXI_168/Perform12_469 ;
  wire \XLXI_168/Perform13_470 ;
  wire \XLXI_168/Perform40_471 ;
  wire \XLXI_168/Perform7_472 ;
  wire \XLXI_168/flag_mux0000<1>12_477 ;
  wire \XLXI_168/flag_mux0000<1>22_478 ;
  wire \XLXI_168/flag_mux0000<1>3_479 ;
  wire \XLXI_168/flag_mux0000<1>30_480 ;
  wire \XLXI_168/flag_mux0000<1>44_481 ;
  wire \XLXI_168/flag_mux0000<2>1_483 ;
  wire \XLXI_168/flag_mux0000<2>14_484 ;
  wire \XLXI_168/flag_mux0000<2>17_485 ;
  wire \XLXI_168/flag_mux0000<2>22_486 ;
  wire \XLXI_168/flag_mux0000<2>6_487 ;
  wire \XLXI_168/flag_mux0000<2>9_488 ;
  wire \XLXI_184/Madd_eNewPC_cy<10>_rt_505 ;
  wire \XLXI_184/Madd_eNewPC_cy<11>_rt_507 ;
  wire \XLXI_184/Madd_eNewPC_cy<12>_rt_509 ;
  wire \XLXI_184/Madd_eNewPC_cy<1>_rt_511 ;
  wire \XLXI_184/Madd_eNewPC_cy<2>_rt_513 ;
  wire \XLXI_184/Madd_eNewPC_cy<3>_rt_515 ;
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
  );
  LUT3 #(
    .INIT ( 8'hE4 ))
  \XLXI_27/o<10>1  (
    .I0(LM_IBUF_206),
    .I1(RD_10_OBUF_323),
    .I2(MD_10_OBUF_225),
    .O(XLXN_61[10])
  );
  LUT3 #(
    .INIT ( 8'hE4 ))
  \XLXI_27/o<0>1  (
    .I0(LM_IBUF_206),
    .I1(RD_0_OBUF_322),
    .I2(MD_0_OBUF_224),
    .O(XLXN_61[0])
  );
  IBUF   MSrc_IBUF (
    .I(MSrc),
    .O(MSrc_IBUF_241)
  );
  IBUF   RESET_IBUF (
    .I(RESET),
    .O(RESET_IBUF_371)
  );
  IBUF   SPW_IBUF (
    .I(SPW),
    .O(SPW_IBUF_400)
  );
  IBUF   IW_IBUF (
    .I(IW),
    .O(IW_IBUF_199)
  );
  IBUF   Jump_IBUF (
    .I(Jump),
    .O(Jump_IBUF_203)
  );
  IBUF   LM_IBUF (
    .I(LM),
    .O(LM_IBUF_206)
  );
  IBUF   M_IBUF (
    .I(M),
    .O(M_IBUF_244)
  );
  IBUF   R_IBUF (
    .I(R),
    .O(R_IBUF_380)
  );
  IBUF   MW_IBUF (
    .I(MW),
    .O(MW_IBUF_243)
  );
  IBUF   SrcB_IBUF (
    .I(SrcB),
    .O(SrcB_IBUF_402)
  );
  IBUF   PCW_IBUF (
    .I(PCW),
    .O(PCW_IBUF_294)
  );
  IBUF   RW_IBUF (
    .I(RW),
    .O(RW_IBUF_379)
  );
  IBUF   SPIorD_IBUF (
    .I(SPIorD),
    .O(SPIorD_IBUF_398)
  );
  IBUF   IorD_IBUF (
    .I(IorD),
    .O(IorD_IBUF_201)
  );
  IBUF   RWSrc_2_IBUF (
    .I(RWSrc[2]),
    .O(RWSrc_2_IBUF_378)
  );
  IBUF   RWSrc_1_IBUF (
    .I(RWSrc[1]),
    .O(RWSrc_1_IBUF_377)
  );
  IBUF   RWSrc_0_IBUF (
    .I(RWSrc[0]),
    .O(RWSrc_0_IBUF_376)
  );
  IBUF   MemA_15_IBUF (
    .I(MemA[15]),
    .O(MemA_15_IBUF_263)
  );
  IBUF   MemA_14_IBUF (
    .I(MemA[14]),
    .O(MemA_14_IBUF_262)
  );
  IBUF   MemA_11_IBUF (
    .I(MemA[11]),
    .O(MemA_11_IBUF_261)
  );
  IBUF   MemA_10_IBUF (
    .I(MemA[10]),
    .O(MemA_10_IBUF_260)
  );
  IBUF   MemA_9_IBUF (
    .I(MemA[9]),
    .O(MemA_9_IBUF_272)
  );
  IBUF   MemA_8_IBUF (
    .I(MemA[8]),
    .O(MemA_8_IBUF_271)
  );
  IBUF   MemA_7_IBUF (
    .I(MemA[7]),
    .O(MemA_7_IBUF_270)
  );
  IBUF   MemA_6_IBUF (
    .I(MemA[6]),
    .O(MemA_6_IBUF_269)
  );
  IBUF   MemA_5_IBUF (
    .I(MemA[5]),
    .O(MemA_5_IBUF_268)
  );
  IBUF   MemA_4_IBUF (
    .I(MemA[4]),
    .O(MemA_4_IBUF_267)
  );
  IBUF   MemA_3_IBUF (
    .I(MemA[3]),
    .O(MemA_3_IBUF_266)
  );
  IBUF   MemA_2_IBUF (
    .I(MemA[2]),
    .O(MemA_2_IBUF_265)
  );
  IBUF   MemA_1_IBUF (
    .I(MemA[1]),
    .O(MemA_1_IBUF_264)
  );
  IBUF   MemA_0_IBUF (
    .I(MemA[0]),
    .O(MemA_0_IBUF_259)
  );
  IBUF   ALUOp_2_IBUF (
    .I(ALUOp[2]),
    .O(ALUOp_2_IBUF_177)
  );
  IBUF   ALUOp_1_IBUF (
    .I(ALUOp[1]),
    .O(ALUOp_1_IBUF_176)
  );
  IBUF   ALUOp_0_IBUF (
    .I(ALUOp[0]),
    .O(ALUOp_0_IBUF_175)
  );
  IBUF   RA_3_IBUF (
    .I(RA[3]),
    .O(RA_3_IBUF_305)
  );
  IBUF   RA_2_IBUF (
    .I(RA[2]),
    .O(RA_2_IBUF_304)
  );
  IBUF   RA_1_IBUF (
    .I(RA[1]),
    .O(RA_1_IBUF_303)
  );
  IBUF   RA_0_IBUF (
    .I(RA[0]),
    .O(RA_0_IBUF_302)
  );
  IBUF   RESETPC_15_IBUF (
    .I(RESETPC[15]),
    .O(RESETPC_15_IBUF_361)
  );
  IBUF   RESETPC_14_IBUF (
    .I(RESETPC[14]),
    .O(RESETPC_14_IBUF_360)
  );
  IBUF   RESETPC_13_IBUF (
    .I(RESETPC[13]),
    .O(RESETPC_13_IBUF_359)
  );
  IBUF   RESETPC_12_IBUF (
    .I(RESETPC[12]),
    .O(RESETPC_12_IBUF_358)
  );
  IBUF   RESETPC_11_IBUF (
    .I(RESETPC[11]),
    .O(RESETPC_11_IBUF_357)
  );
  IBUF   RESETPC_10_IBUF (
    .I(RESETPC[10]),
    .O(RESETPC_10_IBUF_356)
  );
  IBUF   RESETPC_9_IBUF (
    .I(RESETPC[9]),
    .O(RESETPC_9_IBUF_370)
  );
  IBUF   RESETPC_8_IBUF (
    .I(RESETPC[8]),
    .O(RESETPC_8_IBUF_369)
  );
  IBUF   RESETPC_7_IBUF (
    .I(RESETPC[7]),
    .O(RESETPC_7_IBUF_368)
  );
  IBUF   RESETPC_6_IBUF (
    .I(RESETPC[6]),
    .O(RESETPC_6_IBUF_367)
  );
  IBUF   RESETPC_5_IBUF (
    .I(RESETPC[5]),
    .O(RESETPC_5_IBUF_366)
  );
  IBUF   RESETPC_4_IBUF (
    .I(RESETPC[4]),
    .O(RESETPC_4_IBUF_365)
  );
  IBUF   RESETPC_3_IBUF (
    .I(RESETPC[3]),
    .O(RESETPC_3_IBUF_364)
  );
  IBUF   RESETPC_2_IBUF (
    .I(RESETPC[2]),
    .O(RESETPC_2_IBUF_363)
  );
  IBUF   RESETPC_1_IBUF (
    .I(RESETPC[1]),
    .O(RESETPC_1_IBUF_362)
  );
  IBUF   RESETPC_0_IBUF (
    .I(RESETPC[0]),
    .O(RESETPC_0_IBUF_355)
  );
  OBUF   LMC_OBUF (
    .I(\XLXI_257/instr [3]),
    .O(LMC)
  );
  OBUF   Perform_OBUF (
    .I(Perform_OBUF_296),
    .O(Perform)
  );
  OBUF   MD_15_OBUF (
    .I(MD_15_OBUF_230),
    .O(MD[15])
  );
  OBUF   MD_14_OBUF (
    .I(MD_14_OBUF_229),
    .O(MD[14])
  );
  OBUF   MD_13_OBUF (
    .I(MD_13_OBUF_228),
    .O(MD[13])
  );
  OBUF   MD_12_OBUF (
    .I(MD_12_OBUF_227),
    .O(MD[12])
  );
  OBUF   MD_11_OBUF (
    .I(MD_11_OBUF_226),
    .O(MD[11])
  );
  OBUF   MD_10_OBUF (
    .I(MD_10_OBUF_225),
    .O(MD[10])
  );
  OBUF   MD_9_OBUF (
    .I(MD_9_OBUF_239),
    .O(MD[9])
  );
  OBUF   MD_8_OBUF (
    .I(MD_8_OBUF_238),
    .O(MD[8])
  );
  OBUF   MD_7_OBUF (
    .I(MD_7_OBUF_237),
    .O(MD[7])
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
    .C(CLK_BUFGP_195),
    .CE(pos),
    .CLR(gd),
    .D(XLXN_637[10]),
    .Q(ALUO[10])
  );
  FDCE #(
    .INIT ( 1'b0 ))
  \XLXI_171/I_Q9  (
    .C(CLK_BUFGP_195),
    .CE(pos),
    .CLR(gd),
    .D(XLXN_637[9]),
    .Q(ALUO[9])
  );
  FDCE #(
    .INIT ( 1'b0 ))
  \XLXI_171/I_Q8  (
    .C(CLK_BUFGP_195),
    .CE(pos),
    .CLR(gd),
    .D(XLXN_637[8]),
    .Q(ALUO[8])
  );
  FDCE #(
    .INIT ( 1'b0 ))
  \XLXI_171/I_Q7  (
    .C(CLK_BUFGP_195),
    .CE(pos),
    .CLR(gd),
    .D(XLXN_637[7]),
    .Q(ALUO[7])
  );
  FDCE #(
    .INIT ( 1'b0 ))
  \XLXI_171/I_Q6  (
    .C(CLK_BUFGP_195),
    .CE(pos),
    .CLR(gd),
    .D(XLXN_637[6]),
    .Q(ALUO[6])
  );
  FDCE #(
    .INIT ( 1'b0 ))
  \XLXI_171/I_Q5  (
    .C(CLK_BUFGP_195),
    .CE(pos),
    .CLR(gd),
    .D(XLXN_637[5]),
    .Q(ALUO[5])
  );
  FDCE #(
    .INIT ( 1'b0 ))
  \XLXI_171/I_Q4  (
    .C(CLK_BUFGP_195),
    .CE(pos),
    .CLR(gd),
    .D(XLXN_637[4]),
    .Q(ALUO[4])
  );
  FDCE #(
    .INIT ( 1'b0 ))
  \XLXI_171/I_Q3  (
    .C(CLK_BUFGP_195),
    .CE(pos),
    .CLR(gd),
    .D(XLXN_637[3]),
    .Q(ALUO[3])
  );
  FDCE #(
    .INIT ( 1'b0 ))
  \XLXI_171/I_Q2  (
    .C(CLK_BUFGP_195),
    .CE(pos),
    .CLR(gd),
    .D(XLXN_637[2]),
    .Q(ALUO[2])
  );
  FDCE #(
    .INIT ( 1'b0 ))
  \XLXI_171/I_Q1  (
    .C(CLK_BUFGP_195),
    .CE(pos),
    .CLR(gd),
    .D(XLXN_637[1]),
    .Q(ALUO[1])
  );
  FDCE #(
    .INIT ( 1'b0 ))
  \XLXI_171/I_Q0  (
    .C(CLK_BUFGP_195),
    .CE(pos),
    .CLR(gd),
    .D(XLXN_637[0]),
    .Q(ALUO[0])
  );

// synthesis translate_on

endmodule

// synthesis translate_off

`ifndef GLBL
`define GLBL

`timescale  1 ps / 1 ps

module glbl ();

    parameter ROC_WIDTH = 100000;
    parameter TOC_WIDTH = 0;

//--------   STARTUP Globals --------------
    wire GSR;
    wire GTS;
    wire GWE;
    wire PRLD;
    tri1 p_up_tmp;
    tri (weak1, strong0) PLL_LOCKG = p_up_tmp;

    wire PROGB_GLBL;
    wire CCLKO_GLBL;

    reg GSR_int;
    reg GTS_int;
    reg PRLD_int;

//--------   JTAG Globals --------------
    wire JTAG_TDO_GLBL;
    wire JTAG_TCK_GLBL;
    wire JTAG_TDI_GLBL;
    wire JTAG_TMS_GLBL;
    wire JTAG_TRST_GLBL;

    reg JTAG_CAPTURE_GLBL;
    reg JTAG_RESET_GLBL;
    reg JTAG_SHIFT_GLBL;
    reg JTAG_UPDATE_GLBL;
    reg JTAG_RUNTEST_GLBL;

    reg JTAG_SEL1_GLBL = 0;
    reg JTAG_SEL2_GLBL = 0 ;
    reg JTAG_SEL3_GLBL = 0;
    reg JTAG_SEL4_GLBL = 0;

    reg JTAG_USER_TDO1_GLBL = 1'bz;
    reg JTAG_USER_TDO2_GLBL = 1'bz;
    reg JTAG_USER_TDO3_GLBL = 1'bz;
    reg JTAG_USER_TDO4_GLBL = 1'bz;

    assign (weak1, weak0) GSR = GSR_int;
    assign (weak1, weak0) GTS = GTS_int;
    assign (weak1, weak0) PRLD = PRLD_int;

    initial begin
	GSR_int = 1'b1;
	PRLD_int = 1'b1;
	#(ROC_WIDTH)
	GSR_int = 1'b0;
	PRLD_int = 1'b0;
    end

    initial begin
	GTS_int = 1'b1;
	#(TOC_WIDTH)
	GTS_int = 1'b0;
    end

endmodule

`endif

// synthesis translate_on
