fredzqm/CPU/Xilinx_implementation/ipcore_dir/MainMemoryBlock/simulation/functional/wave_ncsim.sv

 
 
 




window new WaveWindow  -name  "Waves for BMG Example Design"
waveform  using  "Waves for BMG Example Design"

      waveform add -signals /MainMemoryBlock_tb/status
      waveform add -signals /MainMemoryBlock_tb/MainMemoryBlock_synth_inst/bmg_port/CLKA
      waveform add -signals /MainMemoryBlock_tb/MainMemoryBlock_synth_inst/bmg_port/ADDRA
      waveform add -signals /MainMemoryBlock_tb/MainMemoryBlock_synth_inst/bmg_port/DINA
      waveform add -signals /MainMemoryBlock_tb/MainMemoryBlock_synth_inst/bmg_port/WEA
      waveform add -signals /MainMemoryBlock_tb/MainMemoryBlock_synth_inst/bmg_port/DOUTA

console submit -using simulator -wait no "run"
