fredzqm/CPU/(commit log)

2015-12-07 built into git
    [DatapathTest.sch, IntegratedTestPCMemIRSp.sch, RTL_control_states.xlsx]
2016-09-17 remove google doc files in the repos, convert them to pdf, word and excel
    [IntegratedTestPCMemIRSp.sch]
2016-09-17 add Xilinx program and .gitignore
    [CPUControl.sch, Datapath.sch, DatapathTest.sch, IntegratedTestALU_Flag.sch, IntegratedTestIR_Flag.sch, IntegratedTestIR_RF.sch, IntegratedTestMemInstr.sch, IntegratedTestMemRFALUFlag.sch]
2016-09-17 remove unecesary old files
    [CPUControl.sch, Datapath.sch, DatapathTest.sch, IntegratedTestALU_Flag.sch, IntegratedTestIR_Flag.sch, IntegratedTestIR_RF.sch, IntegratedTestMemInstr.sch, IntegratedTestMemRFALUFlag.sch]
